SoMuchHat/ReflowOvenCape/README.md

# ReflowOvenCape
Cape for STM32 Nucleo that allows control of DIY reflow oven using
