SoMuchHat/ReflowOvenCape/BOM.xlsx

Reflow Oven BOM |  |  | Digikey
 |  |  |  |  |  | Sean's BOM | Different?
Identifier | Value | Quantity | Description | Footprint | Farnell Code | Digi-Key Code
C1 | 10u | 3 | Polarized capacitor (Radial) | CAPPR2-5x11 | 1902913 | 493-5362-1-ND | Yes
C2 | 22u | 2 | Polarized capacitor (Radial) | CAPPR2-5x11 | 1870976 | P5179-ND | Yes
C8 | 100n | 6 | Ceramic capacitor | 2.54mm | 2309020 | 478-3187-ND | Yes
C10 | 10n | 1 | Ceramic capacitor | 5.08mm | 2309024 | 399-4208-ND | Yes
FB1, FB2 | BLM18PG221SN1D | 2 | Ferrite bead | AXIAL-0.3 | 2292304 | 240-2438-1-ND
P4 |  | 2 | Header, 4-Pin | 2.54mm |  | 3M9449-ND | Yes
R1 | 180 | 1 | Resistor
R2, R5, R12 | 1K | 3 | Resistor
R3 | 275VRMS | 1 | Varistor | Varistor 20D series | 1856919 | MOV-20D431KTRCT-ND | Yes
R4 | 47 | 1 | Resistor
R6 | 470 | 1 | Resistor
R7, R9, R10, R11 | 10K | 4 | Resistor
U5 | MAX31855KASA+ | 1 | Thermocouple Digital Converter | SOIC127P600-8AN |  | MAX31855KASA+-ND | No
 | Thermocouple | 1 | K-Type thermocouple | Bare wire
 | Hex PCB Standoffs | 4
 | HC-06 | 1 | Bluetooth module
 | PCB jumpers | 5 | 2-pin PCB jumpers | 2.54mm |  | 3M9580-ND
 |  | 3 | 2-Pin PCB terminal block | 5.04mm |  | ED2902-ND | CHECK BOARD
