SoMuchHat/ReflowOvenCape/ReflowOven/ReflowOven.ioc

Mcu.UserName=STM32F303RETx
PA10.Signal=USART1_RX
PA2.Signal=USART2_TX
PA3.Signal=USART2_RX
PA9.Signal=USART1_TX
PB12.Signal=GPIO_Output
PB13.Signal=SPI2_SCK
PB14.Signal=SPI2_MISO
PB15.Signal=SPI2_MOSI
PC11.Signal=GPIO_Output
PC6.Signal=GPIO_Input
PC8.Signal=GPIO_Input
PC9.Signal=GPIO_Input
PD2.Signal=GPIO_Output
