SoMuchHat/ReflowOvenCape/ReflowOven/Inc/state.h

/*
 * state.h
 *
 *  Created on: Apr 29, 2017
 *      Author: Sean Harrington
 */

#ifndef STATE_H_
#define STATE_H_

/*
 * This function is responsible for reading user and any device inputs and
 * updating the state of the machine as needed.
 */
void Update_State(void);

#endif /* STATE_H_ */
