SoMuchHat/ReflowOvenCape/(commit log)

2017-03-30 First commit for Reflow Oven Controller. Lots of problems that need addressing. STM32 Nucleo pin headers are incorrect, 5v to 3v3 regulator not needed, missing reverse voltage protection
    [BOM.xlsx, ReflowOven.brd, ReflowOven.sch]
2017-03-30 Insignificant board changes
    [ReflowOven.brd, ReflowOven.sch]
2017-04-05 Made final changes to rev 1. Sent out for manufacturing. Need to update BOM
    [ReflowOven.brd, ReflowOven.sch]
2017-06-11 Known issues found from populating PCB. Updated BT protocol
    [BOM.xlsx, ReflowOven.brd]
2018-04-08 Added STM32 MCU code and Android controller demo code
    [ReflowOven Debug (2).cfg, ReflowOven.cfg]
